menymp/yapscSystem/docs/mesa_0308_servo_diagram.jpg

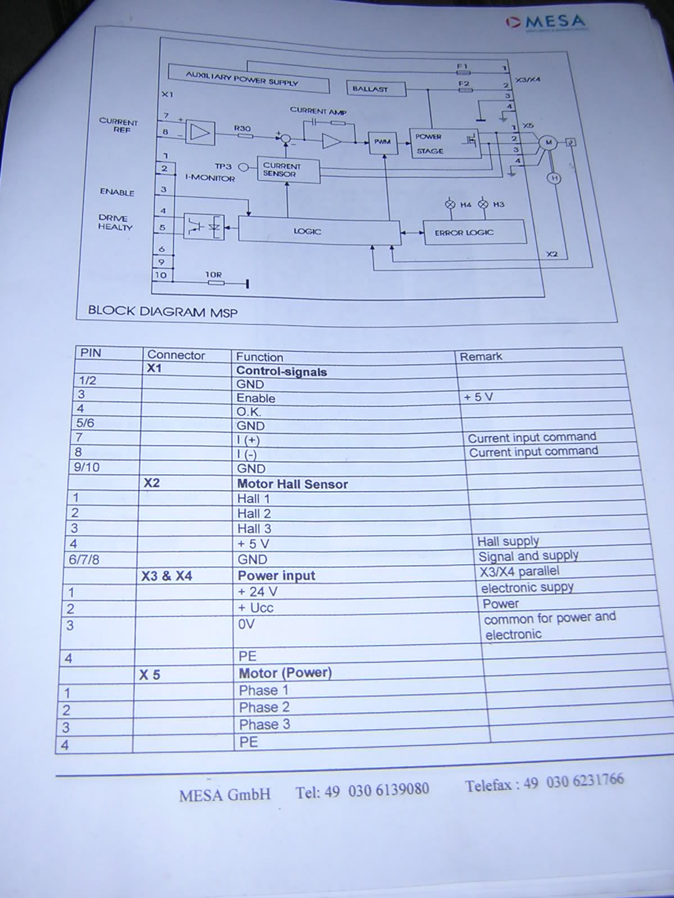
docs/mesa_0308_servo_diagram.jpg
