menymp/yapscSystem/docs/madness.jpg

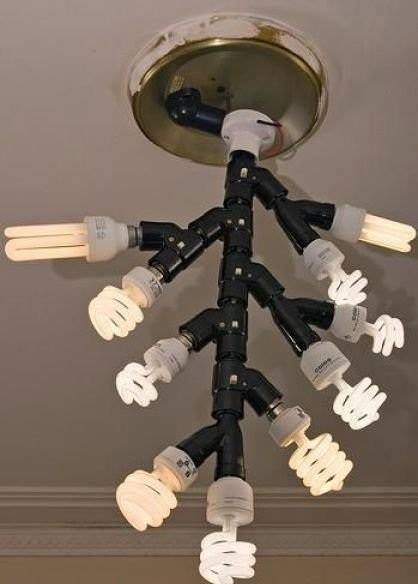
docs/madness.jpg
