menymp/yapscSystem/docs/DSC02786.JPG

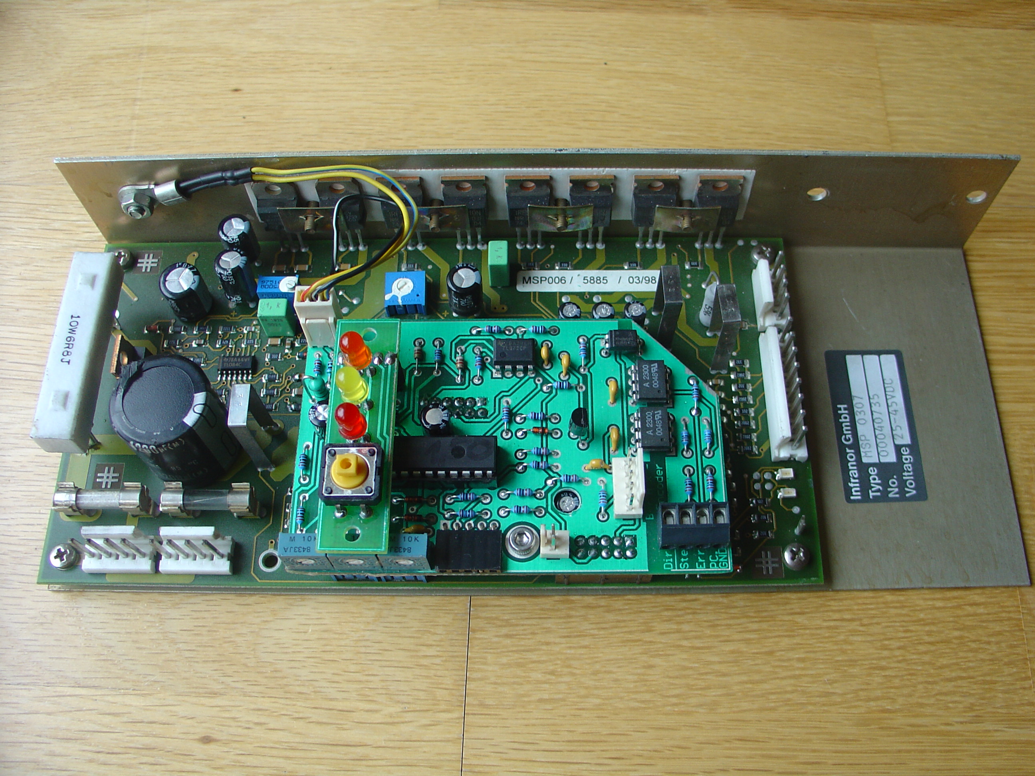
docs/DSC02786.JPG
