menymp/yapscSystem/docs/DSC02804.JPG

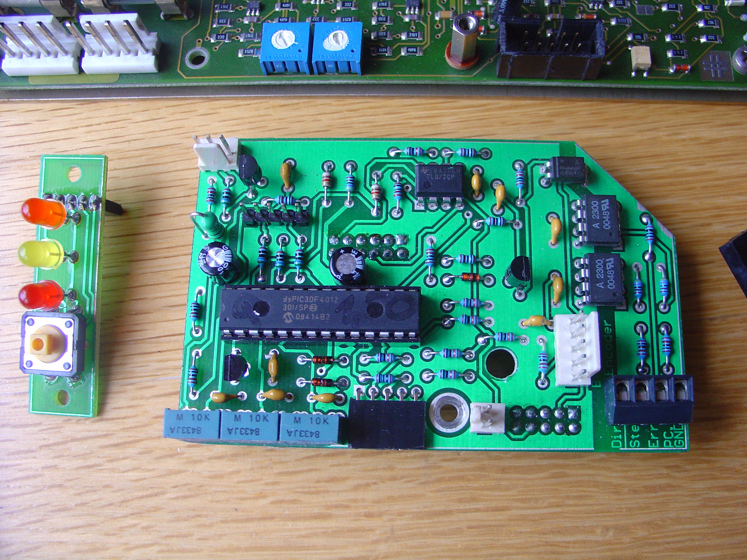
docs/DSC02804.JPG
