menymp/yapscSystem/docs/how-rotary-encoder-works.png

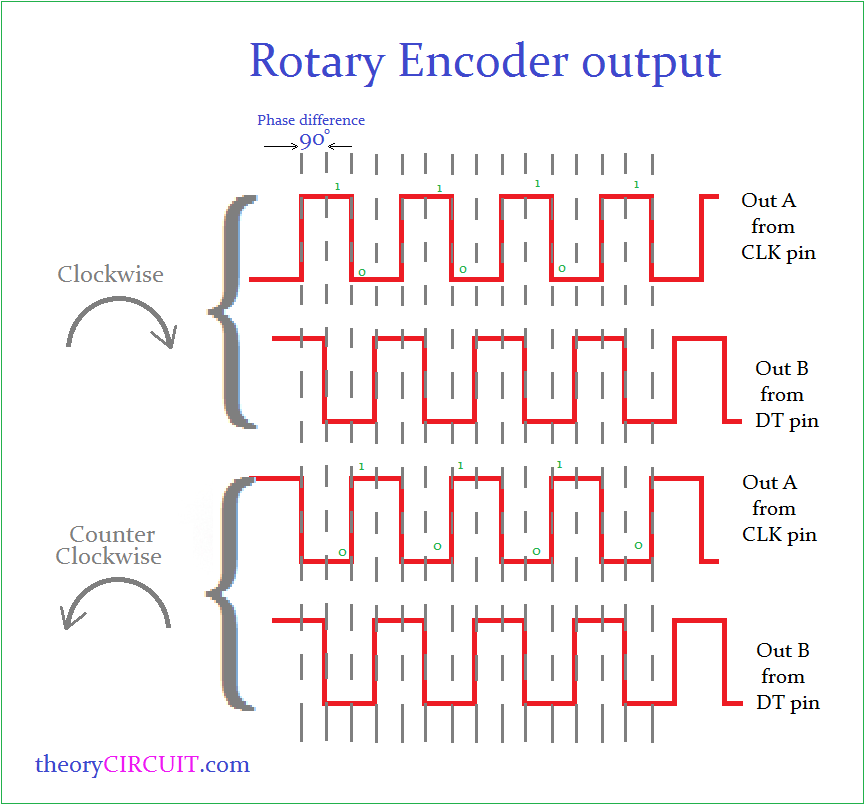
docs/how-rotary-encoder-works.png
