menymp/yapscSystem/docs/MAW_sch.jpg

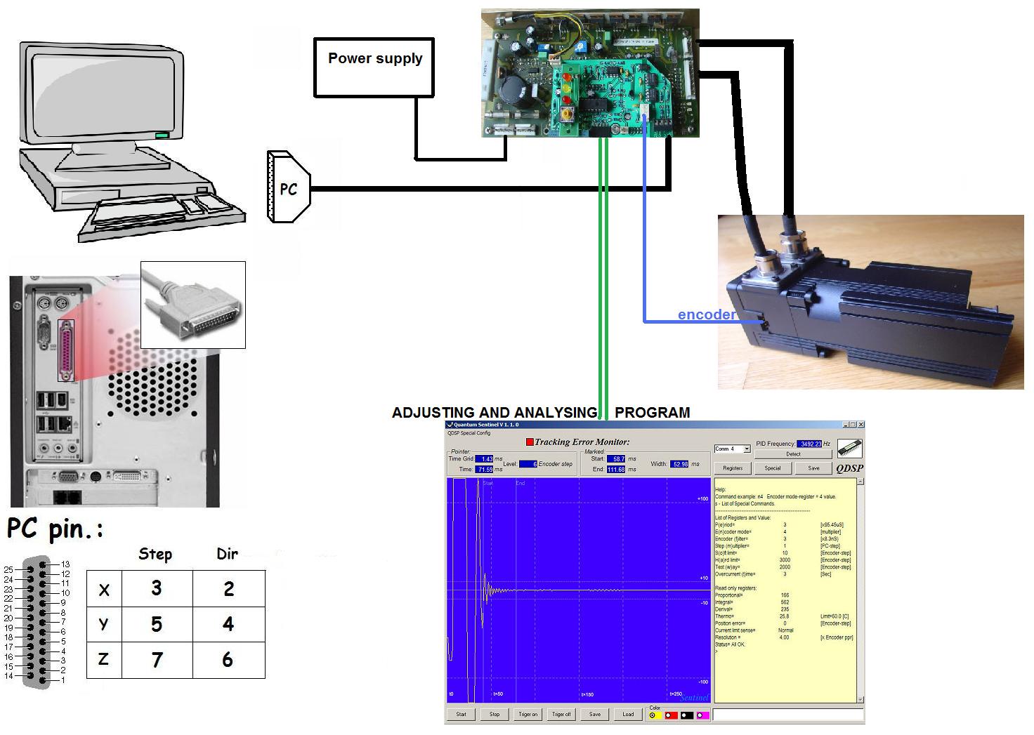
docs/MAW_sch.jpg
