menymp/yapscSystem/docs/Gerber.xlsx

 | YAPSC 10 |  |  |  |  |  |  |  | D1 | RECTIFICADOR |  | th | 2.204
 |  |  |  |  |  |  |  |  | D2 | RECTIFICADOR |  | th | 2.204
Part Value | Component | NUM |  | precio |  |  |  |  | D3 | LED SMD | 12 | VERDE | 11.704
 | 6N137 | 3 | th | 132.81 |  |  |  |  | D4 | LED SMD | 12 | VERDE | 11.704
 | LM339D | 1 | smd | 11.761 |  |  |  |  | D5 | LED SMD | 5 | VERDE | 11.704
 | 74HC14 | 1 | th | 16.245 | C1 | Entrada 7805 pequeno | SMD | 2.755 | D6 | LED SMD | ERR | ROJO | 11.704
u1 | lm7805 | 1 | th | 15 | C2 | ENTRADA 7805 | SMD | 10.887 |  |  |  | Total | 51.224
u6 | lm358 | 1 | th | 14.934 | C3 | Filtro 12v pequeno | SMD | 2.755
 | dsPIC30F4012 | 1 | smd | 141.17 | C4 | TIERRA LM358 FILTRO | SMD | 10.887
 |  |  | Total | 331.92 | C5 | Filtro +-12v | SMD | 10.887
 |  |  |  |  | C6 | Filtro +-12v | SMD | 10.887
 |  |  | precio |  | C7 | SALIDA 7805 pequeno | SMD | 2.755
r1 | 1k | smd | 2.85 |  | C8 | SALIDA 7805 | SMD | 10.887 |  | JLPCB | 2 caras | 10x10 | stencil
r2 | 1k | smd | 2.85 |  | C9 | Filtro 5v PEQUENO | SMD | 2.755 |  | 26 usd | 5 pcbs
r3 | 220 | smd | 2.85 |  | C10 | 33nF PEQUENO | SMD | 2.755 |  | Total | 494
r4 | 220 | smd | 2.85 |  | C11 | 33nF PEQUENO | SMD | 2.755
r5 | 4.7k | smd | 2.85 |  | C12 | 33nF PEQUENO | SMD | 2.755
R6 | 470 | smd | 2.85 |  |  |  | Total | 73.72
R7 | 470 | smd | 2.85
R8 | 4.7K | smd | 2.85
R9 | 4.7K | smd | 2.85
R10 | 470 | smd | 2.85
R11 | 4.7K | smd | 2.85 |  |  |  | Precio total | 1012.164
r12 | 22k | TH | 1
r13 | 22k | TH | 1
r14 | 47k | th | 1
r15 | 47k | TH | 1
r16 | 22k | TH | 1
r17 | R | TH | 1
r18 | R | th | 1
r19 | 100 | smd | 2.85
r20 | R | th | 1
R21 | R | th | 1
r22 | 1k | smd | 2.85
R23 | 1K | smd | 2.85
R24 | 1K | smd | 2.85
R25 | 4.7K | smd | 2.85
R26 | 4.7K | smd | 2.85
R27 | 4.7K | smd | 2.85
Q1 | NPN | SMD | 1
Total |  |  | 61.3
