menymp/yapscSystem/(list of files, drawings)

Other design files:
docs/Filtro_simulacion.pdsprj
