menymp/yapscSystem/(commit log)

2023-04-01 fix output bug related to wrong output direction parse
    [yapscState.py]
2023-04-01 bug fix, add control over base direction command for motor out direction
    [yapscGui.py, yapscState.py]
2023-04-01 bug fix, missing driver implementations
    [main.py]
2023-04-02 fix bug for setpoint in step dir control mode, value couldnt not update with external signal, UI add larger spinbox value fields
    [main.py, servoController.py, stepDirInterface.py, yapscGui.py]
2023-11-01 add old maxon docs
    [Filtro_simulacion.pdsprj, Gerber.xlsx]
